knurtz/WordclockX/Mechanical/uhr_komplett.STL

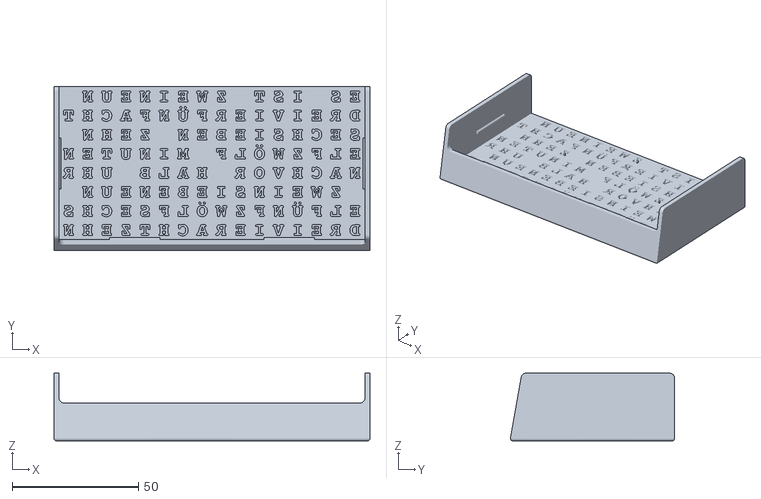
[picture p1: CAD file, 2023-04-30]
Mechanical/uhr_komplett.STL
125.0 x 65.0 x 26.8
