knurtz/WordclockX/Mechanical/uhr_unten_links.STL

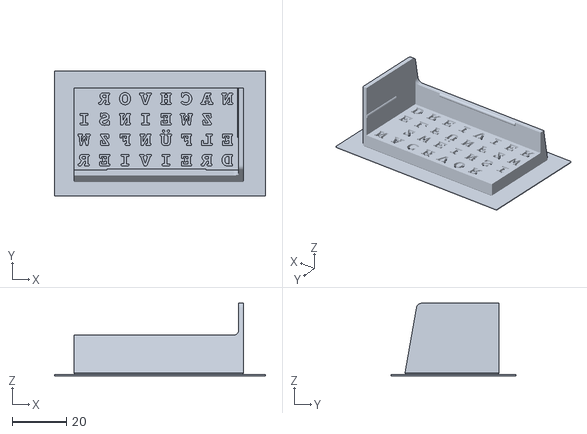
[picture p2: CAD file, 2023-04-30]
Mechanical/uhr_unten_links.STL
77.8 x 46.1 x 26.8
