knurtz/WordclockX/Mechanical/WordclockFrame.stl

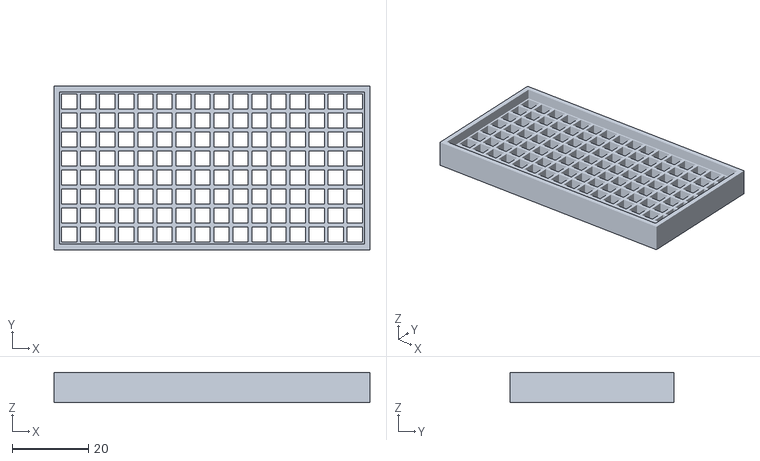
[picture p3: CAD file, 2023-04-30]
Mechanical/WordclockFrame.stl
83.0 x 43.0 x 8.00
