knurtz/WordclockX/Mechanical/uhr_oben_links.STL

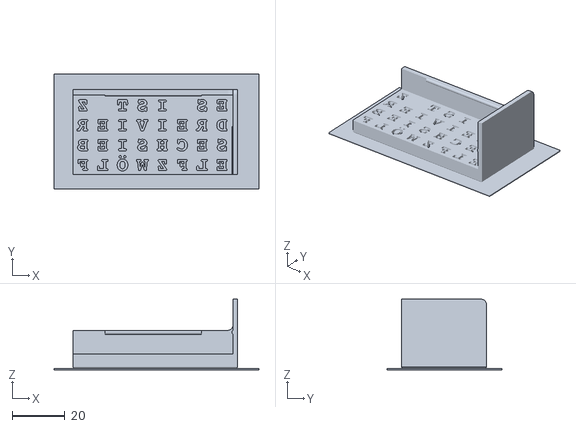
[picture p4: CAD file, 2023-04-30]
Mechanical/uhr_oben_links.STL
77.8 x 43.6 x 26.8
