knurtz/WordclockX/Mechanical/uhr_unten_rechts.STL

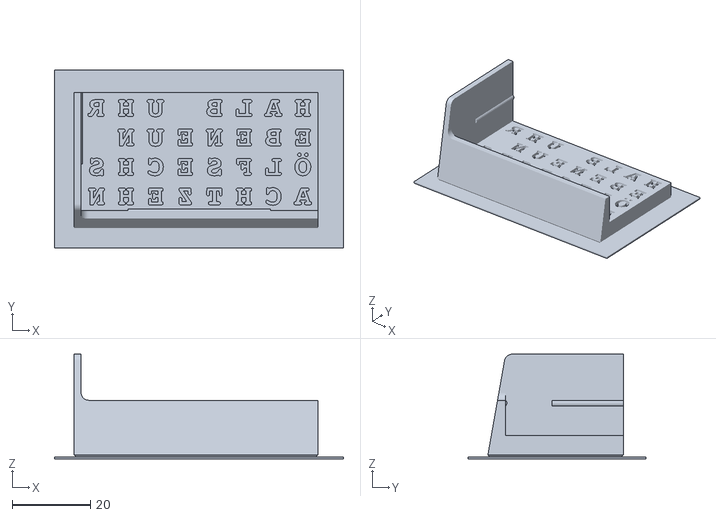
[picture p5: CAD file, 2023-04-30]
Mechanical/uhr_unten_rechts.STL
74.0 x 45.7 x 26.8
