knurtz/WordclockX/Mechanical/uhr_oben_rechts.STL

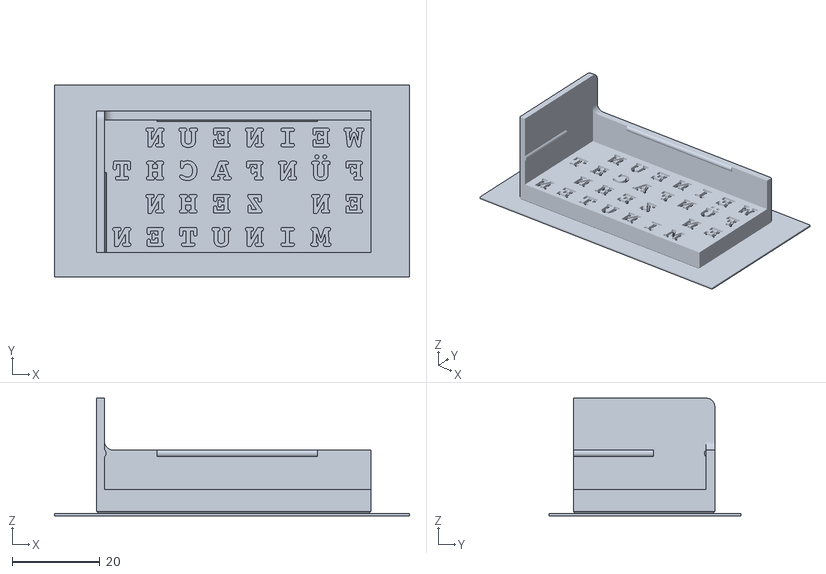
[picture p6: CAD file, 2023-04-30]
Mechanical/uhr_oben_rechts.STL
80.9 x 43.6 x 26.8
