knurtz/WordclockX/(list of files, cad)

Other CAD files:
Letters/letters.dxf
