knurtz/WordclockX/Board/WordclockX.kicad_pcb

## KiCad design Board/WordclockX.kicad_pcb (2023-06-25)

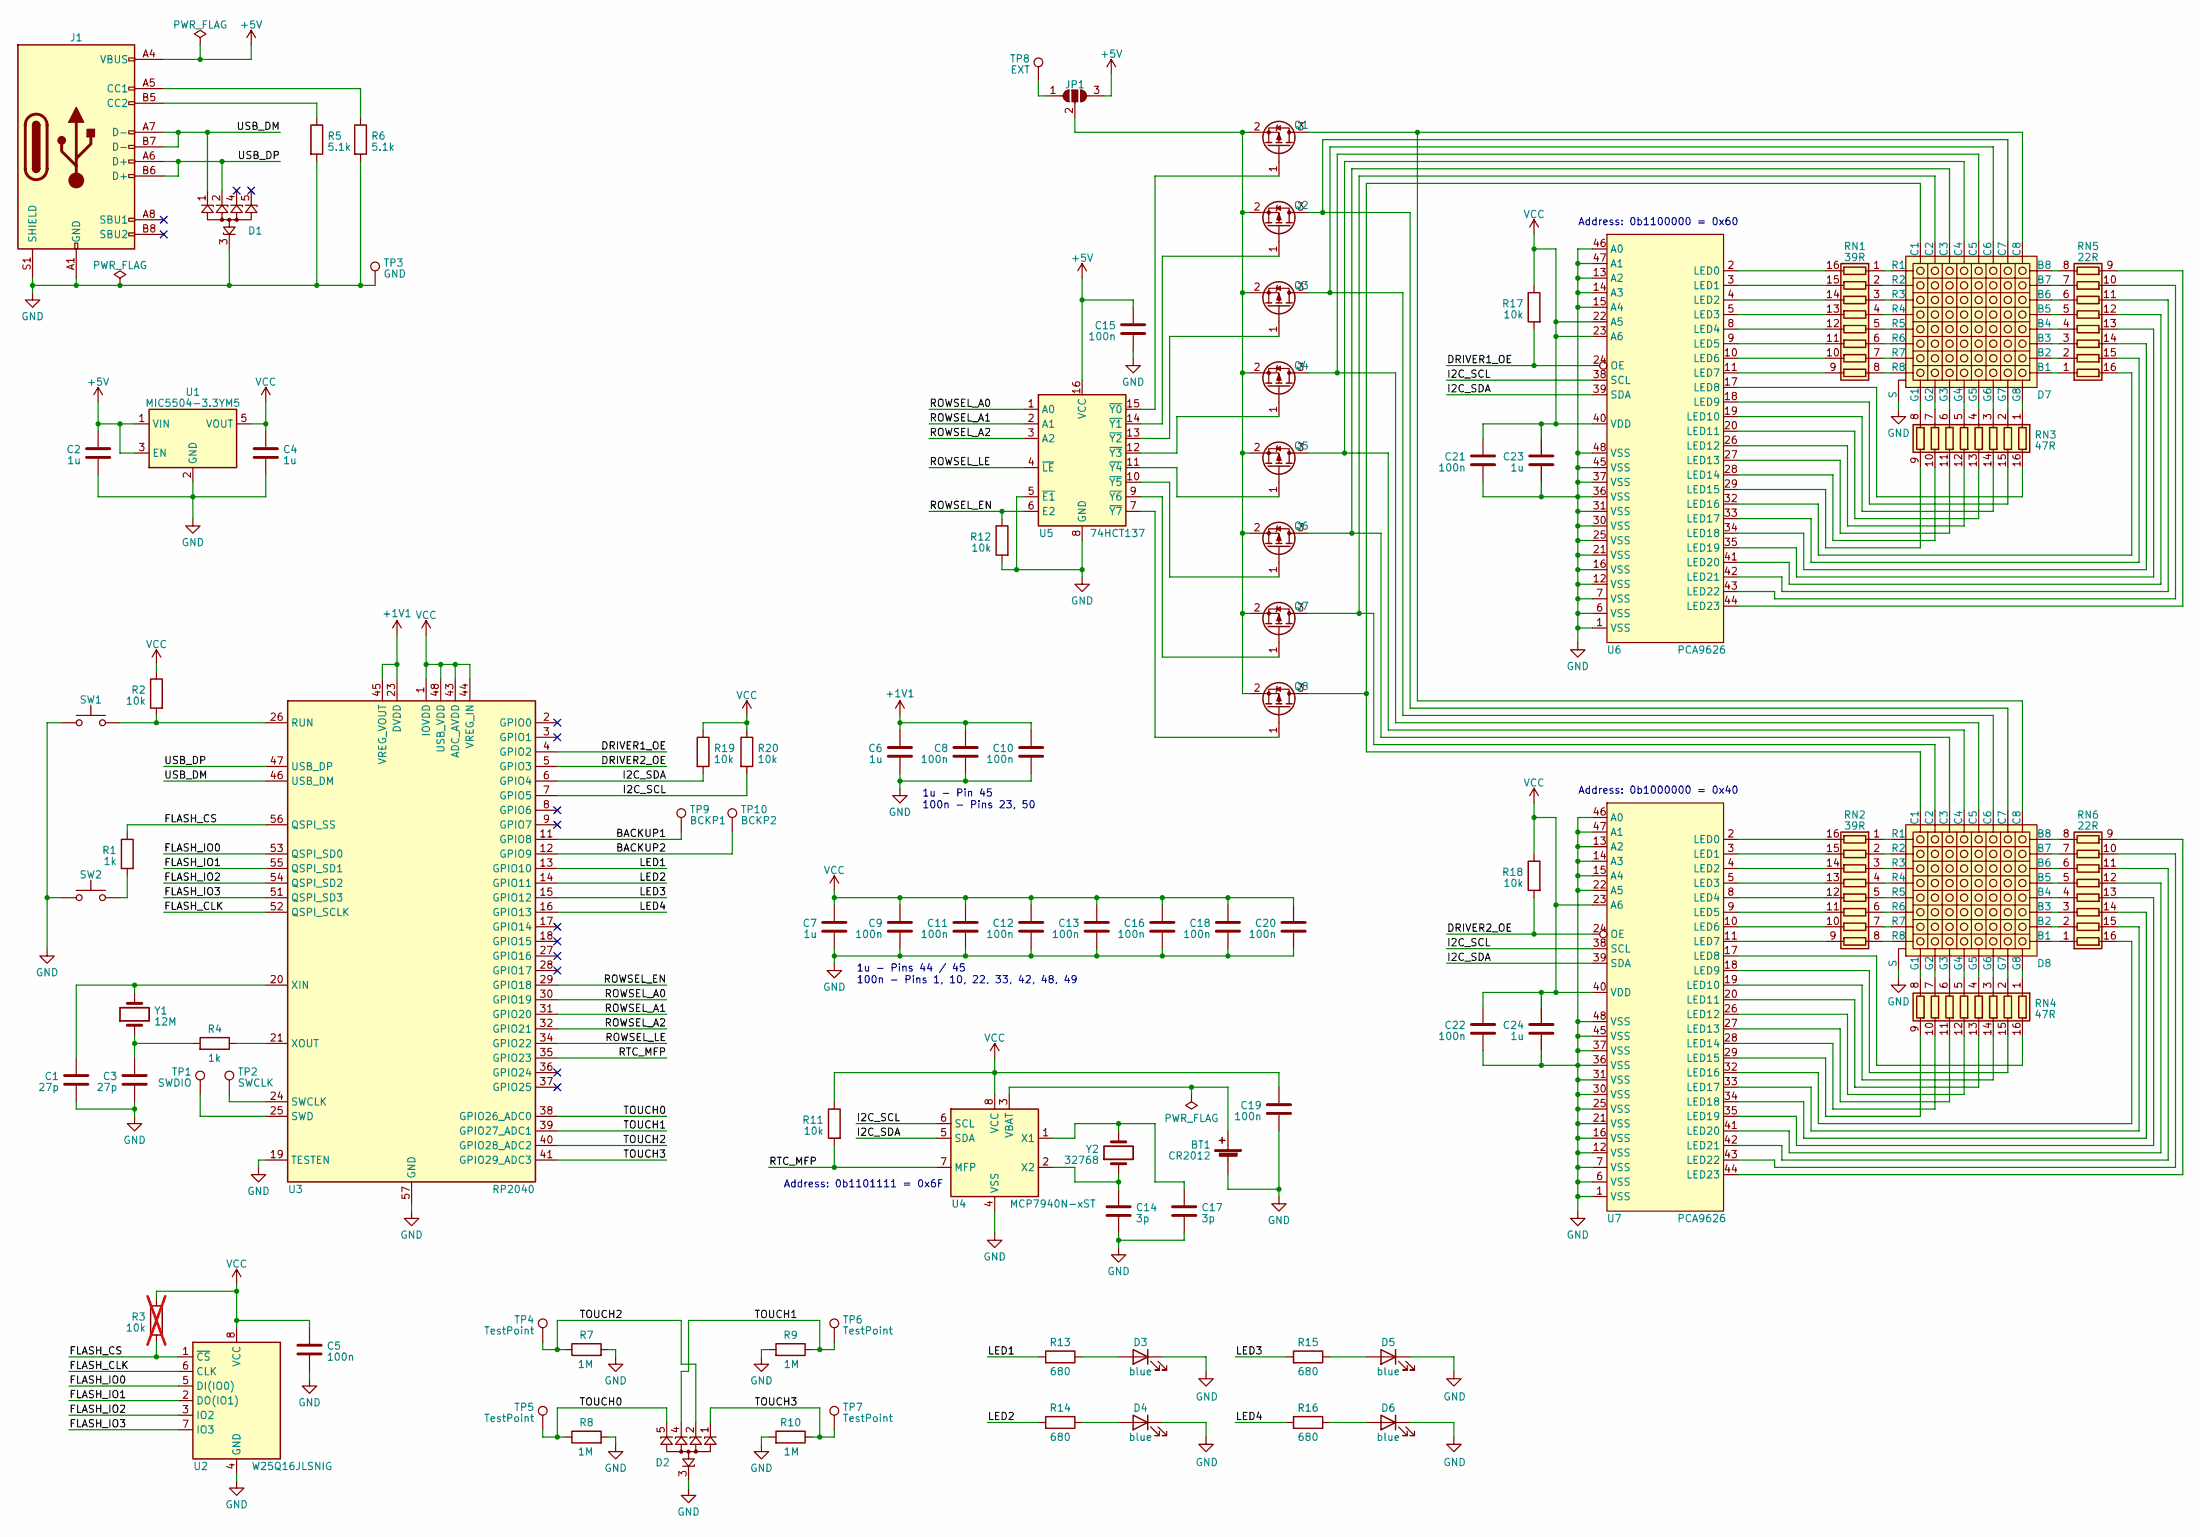
[picture p7: schematic WordclockX.kicad_sch]

Parts:
BT1: CR2012; BatteryHolder_MPD_BC2003_1x2032; Mouser 712-BAT-HLD-002-SMT
C1, C3: 27p; C_0603_1608Metric
C2, C4, C6, C7, C23, C24: 1u; C_0805_2012Metric
C5, C8, C9, C10, C11, C12, C13, C15, C16, C18, C19, C20, C21, C22: 100n; C_0603_1608Metric
C14, C17: 3p; C_0603_1608Metric
D1, D2: Diodes_UDFN-10_1.0x2.5mm_P0.5mm; Mouser 576-SP1064E-04UTG
D3, D4, D5, D6: blue; LED_0603_1608Metric; Mouser 710-150060BS75000
D7, D8: RGB2088-5; 2088RGB-5_no-holes
J1: USB_C_Receptacle_USB2.0; USB_C_Receptacle_GCT_USB4145
JP1: SolderJumper_3_Open; SolderJumper-3_P1.3mm_Open_RoundedPad1.0x1.5mm
Q1, Q2, Q3, Q4, Q5, Q6, Q7, Q8: SOT-23; Mouser 241-PJA3415AAUR100A1
R1, R4: 1k; R_0603_1608Metric
R2, R11, R12, R17, R18, R19, R20: 10k; R_0603_1608Metric
R3: 10k; R_0603_1608Metric; not fitted
R5, R6: 5.1k; R_0603_1608Metric
R7, R8, R9, R10: 1M; R_0603_1608Metric
R13, R14, R15, R16: 680; R_0603_1608Metric
RN1, RN2: 39R; R_Array_Convex_8x0602; Mouser 667-EXB-2HV390JV
RN3, RN4: 47R; R_Array_Convex_8x0602; Mouser 667-EXB-2HV470JV
RN5, RN6: 22R; R_Array_Convex_8x0602; Mouser 667-EXB-2HV220JV
SW1, SW2: SW_Push_Dual; SW_Push_1P1T_NO_CK_KSC6xxJ
TP1: SWDIO; TestPoint_Pad_1.0x1.0mm
TP2: SWCLK; TestPoint_Pad_1.0x1.0mm
TP3: GND; TestPoint_Pad_1.0x1.0mm
TP4, TP5, TP6, TP7: TestPoint; TestPoint_Pad_D4.0mm
TP8: EXT; TestPoint_Pad_1.0x1.0mm
TP9: BCKP1; TestPoint_Pad_1.0x1.0mm
TP10: BCKP2; TestPoint_Pad_1.0x1.0mm
U1: MIC5504-3.3YM5; SOT-23-5; Mouser 998-MIC5504-3.3YM5TR
U2: W25Q16JLSNIG; SOIC-8_3.9x4.9mm_P1.27mm; Mouser 454-W25Q16JLSNIG
U3: RP2040; QFN-56-1EP_7x7mm_P0.4mm_EP3.2x3.2mm
U4: MCP7940N-xST; TSSOP-8_4.4x3mm_P0.65mm; Mouser 579-MCP7940N-I/ST
U5: 74HCT137; SOIC-16_3.9x9.9mm_P1.27mm; Mouser 595-CD74HCT137MT
U6, U7: PCA9626; LQFP-48_7x7mm_P0.5mm
Y1: 12M; Crystal_SMD_5032-2Pin_5.0x3.2mm; Mouser 774-445C25D12M00000
Y2: 32768; Crystal_SMD_3215-2Pin_3.2x1.5mm; Mouser 628-SC32S-7PF20PPM

Connections:
+1V1: C6.1, C8.1, C10.1, U3.23 (DVDD), U3.45 (VREG_VOUT), U3.50 (DVDD)
+5V: C2.1, C15.1, J1.A4 (VBUS), J1.A9 (VBUS), J1.B4 (VBUS), J1.B9 (VBUS), JP1.3 (B), U1.1 (VIN), U1.3 (EN), U5.16 (VCC)
/BACKUP1: TP9.1, U3.11 (GPIO8)
/BACKUP2: TP10.1, U3.12 (GPIO9)
/DRIVER1_OE: R17.2, U3.4 (GPIO2), U6.24 (OE)
/DRIVER2_OE: R18.2, U3.5 (GPIO3), U7.24 (OE)
/FLASH_CLK: U2.6 (CLK), U3.52 (QSPI_SCLK)
/FLASH_CS: R1.1, R3.2, U2.1 (~CS), U3.56 (QSPI_SS)
/FLASH_IO0: U2.5 (DI(IO0)), U3.53 (QSPI_SD0)
/FLASH_IO1: U2.2 (DO(IO1)), U3.55 (QSPI_SD1)
/FLASH_IO2: U2.3 (IO2), U3.54 (QSPI_SD2)
/FLASH_IO3: U2.7 (IO3), U3.51 (QSPI_SD3)
/I2C_SCL: R20.2, U3.7 (GPIO5), U4.6 (SCL), U6.38 (SCL), U7.38 (SCL)
/I2C_SDA: R19.2, U3.6 (GPIO4), U4.5 (SDA), U6.39 (SDA), U7.39 (SDA)
/LED1: R13.2, U3.13 (GPIO10)
/LED2: R14.2, U3.14 (GPIO11)
/LED3: R15.2, U3.15 (GPIO12)
/LED4: R16.2, U3.16 (GPIO13)
/ROWSEL_A0: U3.30 (GPIO19), U5.1 (A0)
/ROWSEL_A1: U3.31 (GPIO20), U5.2 (A1)
/ROWSEL_A2: U3.32 (GPIO21), U5.3 (A2)
/ROWSEL_EN: R12.1, U3.29 (GPIO18), U5.6 (E2)
/ROWSEL_LE: U3.34 (GPIO22), U5.4 (~LE)
/RTC_MFP: R11.2, U3.35 (GPIO23), U4.7 (MFP)
/TOUCH0: D2.5 (Ch.4), D2.6 (Ch.4), R8.1, TP5.1, U3.38 (GPIO26_ADC0)
/TOUCH1: D2.4 (Ch.3), D2.7 (Ch.3), R9.1, TP6.1, U3.39 (GPIO27_ADC1)
/TOUCH2: D2.2 (Ch.2), D2.9 (Ch.2), R7.1, TP4.1, U3.40 (GPIO28_ADC2)
/TOUCH3: D2.1 (Ch.1), D2.10 (Ch.1), R10.1, TP7.1, U3.41 (GPIO29_ADC3)
/USB_DM: D1.1 (Ch.1), D1.10 (Ch.1), J1.A7 (D-), J1.B7 (D-), U3.46 (USB_DM)
/USB_DP: D1.2 (Ch.2), D1.9 (Ch.2), J1.A6 (D+), J1.B6 (D+), U3.47 (USB_DP)
GND: BT1.2 (-), C1.2, C2.2, C3.2, C4.2, C5.2, C6.2, C7.2, C8.2, C9.2, C10.2, C11.2, C12.2, C13.2, C14.2, C15.2, C16.2, C17.2, C18.2, C19.2, C20.2, C21.2, C22.2, C23.2, C24.2, D1.3 (GND), D1.8 (GND), D2.3 (GND), D2.8 (GND), D3.1 (K), D4.1 (K), D5.1 (K), D6.1 (K), D7.S, D8.S, J1.A1 (GND), J1.A12 (GND), J1.B1 (GND), J1.B12 (GND), J1.S1 (SHIELD), R5.2, R6.2, R7.2, R8.2, R9.2, R10.2, R12.2, SW1.1, SW2.1, TP3.1, U1.2 (GND), U2.4 (GND), U3.19 (TESTEN), U3.57 (GND), U4.4 (VSS), U5.5 (~E1), U5.8 (GND), U6.1 (VSS), U6.6 (VSS), U6.7 (VSS), U6.12 (VSS), U6.13 (A2), U6.14 (A3), U6.15 (A4), U6.16 (VSS), U6.21 (VSS), U6.25 (VSS), U6.30 (VSS), U6.31 (VSS), U6.36 (VSS), U6.37 (VSS), U6.45 (VSS), U6.46 (A0), U6.47 (A1), U6.48 (VSS), U7.1 (VSS), U7.6 (VSS), U7.7 (VSS), U7.12 (VSS), U7.13 (A2), U7.14 (A3), U7.15 (A4), U7.16 (VSS), U7.21 (VSS), U7.22 (A5), U7.25 (VSS), U7.30 (VSS), U7.31 (VSS), U7.36 (VSS), U7.37 (VSS), U7.45 (VSS), U7.46 (A0), U7.47 (A1), U7.48 (VSS)
unnamed: BT1.1 (+), U4.3 (VBAT)
unnamed: C3.1, R4.2, Y1.1
unnamed: D3.2 (A), R13.1
unnamed: D4.2 (A), R14.1
unnamed: D5.2 (A), R15.1
unnamed: D6.2 (A), R16.1
unnamed: D7.1 (B1), RN5.1 (R1.1)
unnamed: D7.2 (B2), RN5.2 (R2.1)
unnamed: D7.3 (B3), RN5.3 (R3.1)
unnamed: D7.4 (B4), RN5.4 (R4.1)
unnamed: D7.5 (B5), RN5.5 (R5.1)
unnamed: D7.6 (B6), RN5.6 (R6.1)
unnamed: D7.7 (B7), RN5.7 (R7.1)
unnamed: D7.8 (B8), RN5.8 (R8.1)
unnamed: D7.17 (C1), D8.17 (C1), Q8.3 (D)
unnamed: D7.18 (C2), D8.18 (C2), Q7.3 (D)
unnamed: D7.19 (C3), D8.19 (C3), Q6.3 (D)
unnamed: D7.20 (C4), D8.20 (C4), Q5.3 (D)
unnamed: D7.29 (C5), D8.29 (C5), Q4.3 (D)
unnamed: D7.30 (C6), D8.30 (C6), Q3.3 (D)
unnamed: D7.31 (C7), D8.31 (C7), Q2.3 (D)
unnamed: D7.32 (C8), D8.32 (C8), Q1.3 (D)
unnamed: D7.28 (G1), RN3.8 (R8.1)
unnamed: D7.27 (G2), RN3.7 (R7.1)
unnamed: D7.26 (G3), RN3.6 (R6.1)
unnamed: D7.25 (G4), RN3.5 (R5.1)
unnamed: D7.24 (G5), RN3.4 (R4.1)
unnamed: D7.23 (G6), RN3.3 (R3.1)
unnamed: D7.22 (G7), RN3.2 (R2.1)
unnamed: D7.21 (G8), RN3.1 (R1.1)
unnamed: D7.9 (R1), RN1.1 (R1.1)
unnamed: D7.10 (R2), RN1.2 (R2.1)
unnamed: D7.11 (R3), RN1.3 (R3.1)
unnamed: D7.12 (R4), RN1.4 (R4.1)
unnamed: D7.13 (R5), RN1.5 (R5.1)
unnamed: D7.14 (R6), RN1.6 (R6.1)
unnamed: D7.15 (R7), RN1.7 (R7.1)
unnamed: D7.16 (R8), RN1.8 (R8.1)
unnamed: D8.1 (B1), RN6.1 (R1.1)
unnamed: D8.2 (B2), RN6.2 (R2.1)
unnamed: D8.3 (B3), RN6.3 (R3.1)
unnamed: D8.4 (B4), RN6.4 (R4.1)
unnamed: D8.5 (B5), RN6.5 (R5.1)
unnamed: D8.6 (B6), RN6.6 (R6.1)
unnamed: D8.7 (B7), RN6.7 (R7.1)
unnamed: D8.8 (B8), RN6.8 (R8.1)
unnamed: D8.28 (G1), RN4.8 (R8.1)
unnamed: D8.27 (G2), RN4.7 (R7.1)
unnamed: D8.26 (G3), RN4.6 (R6.1)
unnamed: D8.25 (G4), RN4.5 (R5.1)
unnamed: D8.24 (G5), RN4.4 (R4.1)
unnamed: D8.23 (G6), RN4.3 (R3.1)
unnamed: D8.22 (G7), RN4.2 (R2.1)
unnamed: D8.21 (G8), RN4.1 (R1.1)
unnamed: D8.9 (R1), RN2.1 (R1.1)
unnamed: D8.10 (R2), RN2.2 (R2.1)
unnamed: D8.11 (R3), RN2.3 (R3.1)
unnamed: D8.12 (R4), RN2.4 (R4.1)
unnamed: D8.13 (R5), RN2.5 (R5.1)
unnamed: D8.14 (R6), RN2.6 (R6.1)
unnamed: D8.15 (R7), RN2.7 (R7.1)
unnamed: D8.16 (R8), RN2.8 (R8.1)
unnamed: J1.A5 (CC1), R6.1
unnamed: J1.B5 (CC2), R5.1
unnamed: JP1.1 (A), TP8.1
unnamed: JP1.2 (C), Q1.2 (S), Q2.2 (S), Q3.2 (S), Q4.2 (S), Q5.2 (S), Q6.2 (S), Q7.2 (S), Q8.2 (S)
unnamed: Q1.1 (G), U5.15 (~Y0)
unnamed: Q2.1 (G), U5.14 (~Y1)
unnamed: Q3.1 (G), U5.13 (~Y2)
unnamed: Q4.1 (G), U5.12 (~Y3)
unnamed: Q5.1 (G), U5.11 (~Y4)
unnamed: Q6.1 (G), U5.10 (~Y5)
unnamed: Q7.1 (G), U5.9 (~Y6)
unnamed: Q8.1 (G), U5.7 (~Y7)
unnamed: R1.2, SW2.2
unnamed: RN1.16 (R1.2), U6.2 (LED0)
unnamed: RN1.15 (R2.2), U6.3 (LED1)
unnamed: RN1.14 (R3.2), U6.4 (LED2)
unnamed: RN1.13 (R4.2), U6.5 (LED3)
unnamed: RN1.12 (R5.2), U6.8 (LED4)
unnamed: RN1.11 (R6.2), U6.9 (LED5)
unnamed: RN1.10 (R7.2), U6.10 (LED6)
unnamed: RN1.9 (R8.2), U6.11 (LED7)
unnamed: RN2.16 (R1.2), U7.2 (LED0)
unnamed: RN2.15 (R2.2), U7.3 (LED1)
unnamed: RN2.14 (R3.2), U7.4 (LED2)
unnamed: RN2.13 (R4.2), U7.5 (LED3)
unnamed: RN2.12 (R5.2), U7.8 (LED4)
unnamed: RN2.11 (R6.2), U7.9 (LED5)
unnamed: RN2.10 (R7.2), U7.10 (LED6)
unnamed: RN2.9 (R8.2), U7.11 (LED7)
unnamed: RN3.16 (R1.2), U6.17 (LED8)
unnamed: RN3.15 (R2.2), U6.18 (LED9)
unnamed: RN3.14 (R3.2), U6.19 (LED10)
unnamed: RN3.13 (R4.2), U6.20 (LED11)
unnamed: RN3.12 (R5.2), U6.26 (LED12)
unnamed: RN3.11 (R6.2), U6.27 (LED13)
unnamed: RN3.10 (R7.2), U6.28 (LED14)
unnamed: RN3.9 (R8.2), U6.29 (LED15)
unnamed: RN4.16 (R1.2), U7.17 (LED8)
unnamed: RN4.15 (R2.2), U7.18 (LED9)
unnamed: RN4.14 (R3.2), U7.19 (LED10)
unnamed: RN4.13 (R4.2), U7.20 (LED11)
unnamed: RN4.12 (R5.2), U7.26 (LED12)
unnamed: RN4.11 (R6.2), U7.27 (LED13)
unnamed: RN4.10 (R7.2), U7.28 (LED14)
unnamed: RN4.9 (R8.2), U7.29 (LED15)
unnamed: RN5.16 (R1.2), U6.32 (LED16)
unnamed: RN5.15 (R2.2), U6.33 (LED17)
unnamed: RN5.14 (R3.2), U6.34 (LED18)
unnamed: RN5.13 (R4.2), U6.35 (LED19)
unnamed: RN5.12 (R5.2), U6.41 (LED20)
unnamed: RN5.11 (R6.2), U6.42 (LED21)
unnamed: RN5.10 (R7.2), U6.43 (LED22)
unnamed: RN5.9 (R8.2), U6.44 (LED23)
unnamed: RN6.16 (R1.2), U7.32 (LED16)
unnamed: RN6.15 (R2.2), U7.33 (LED17)
unnamed: RN6.14 (R3.2), U7.34 (LED18)
unnamed: RN6.13 (R4.2), U7.35 (LED19)
unnamed: RN6.12 (R5.2), U7.41 (LED20)
unnamed: RN6.11 (R6.2), U7.42 (LED21)
unnamed: RN6.10 (R7.2), U7.43 (LED22)
unnamed: RN6.9 (R8.2), U7.44 (LED23)
unnamed: R2.2, SW1.2, U3.26 (RUN)
unnamed: TP2.1, U3.24 (SWCLK)
unnamed: TP1.1, U3.25 (SWD)
unnamed: C1.1, U3.20 (XIN), Y1.2
unnamed: R4.1, U3.21 (XOUT)
unnamed: C17.1, U4.1 (X1), Y2.2
unnamed: C14.1, U4.2 (X2), Y2.1
VCC: C4.1, C5.1, C7.1, C9.1, C11.1, C12.1, C13.1, C16.1, C18.1, C19.1, C20.1, C21.1, C22.1, C23.1, C24.1, R2.1, R3.1, R11.1, R17.1, R18.1, R19.1, R20.1, U1.5 (VOUT), U2.8 (VCC), U3.1 (IOVDD), U3.10 (IOVDD), U3.22 (IOVDD), U3.33 (IOVDD), U3.42 (IOVDD), U3.43 (ADC_AVDD), U3.44 (VREG_IN), U3.48 (USB_VDD), U3.49 (IOVDD), U4.8 (VCC), U6.22 (A5), U6.23 (A6), U6.40 (VDD), U7.23 (A6), U7.40 (VDD)

Notes on the sheet:
Address: 0b1000000 = 0x40
1u - Pin 45 100n - Pins 23, 50
1u - Pins 44 / 45 100n - Pins 1, 10, 22, 33, 42, 48, 49
Address: 0b1101111 = 0x6F
Address: 0b1100000 = 0x60

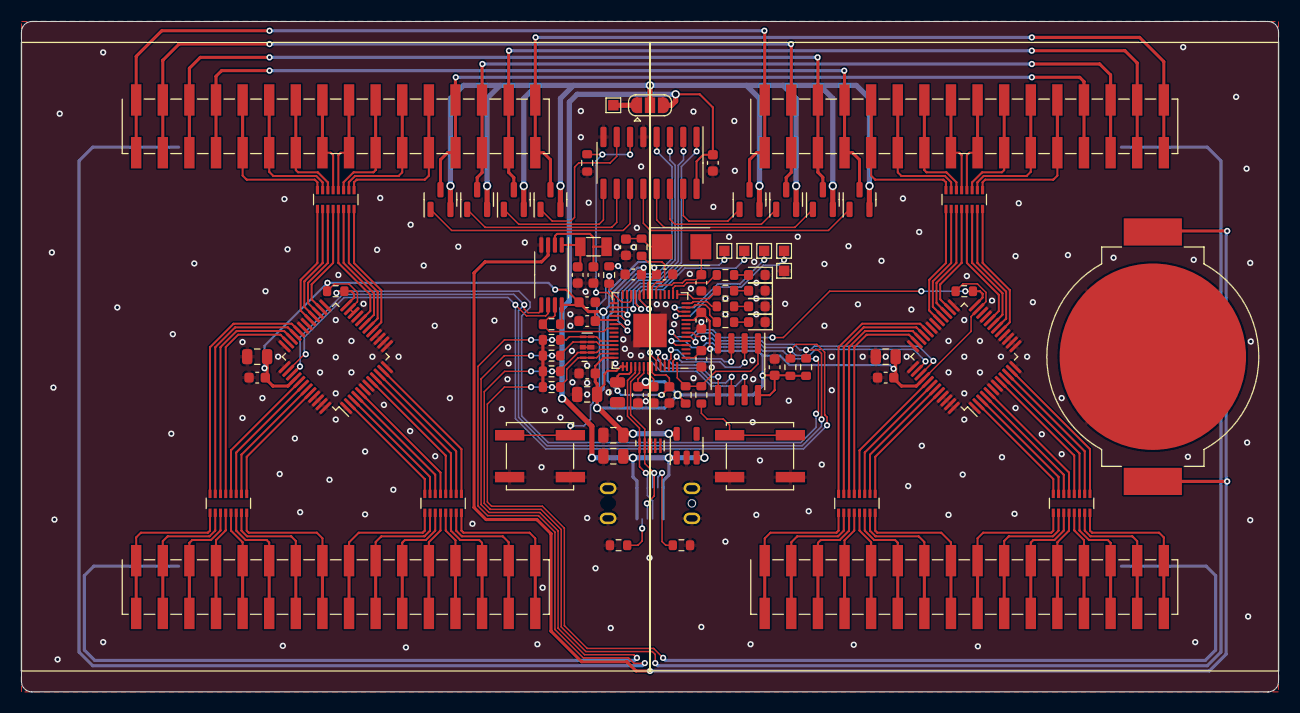
[picture p8: board WordclockX.kicad_pcb from above]

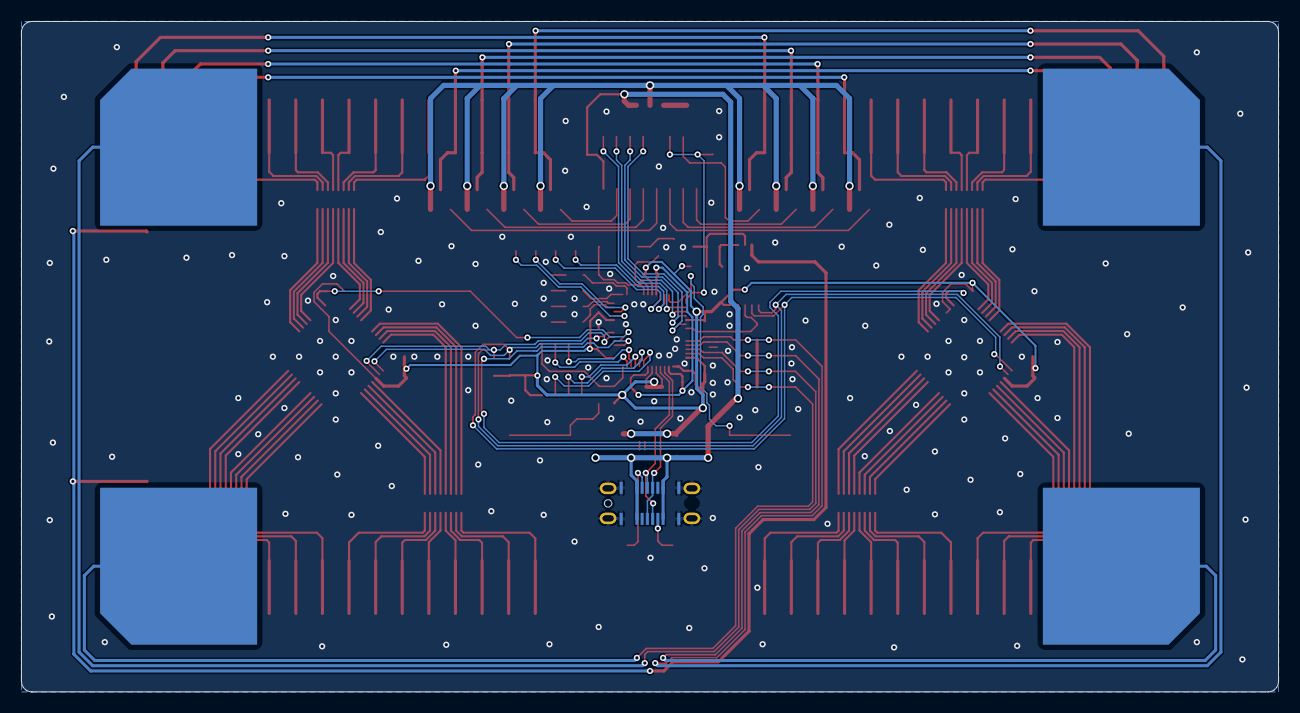
[picture p9: board WordclockX.kicad_pcb from below]

Board: 2 copper layers, 120.0 x 64.0 mm, 90 parts (5 on the bottom side), 162 nets.
