knurtz/WordclockX/Code/hardware/hardware.h

#ifndef HARDWARE_H
#define HARDWARE_H

#include "pico/stdlib.h"

#define kHz * 1000
#define MHz * 1000 * 1000

// Generic IOs
#define LED1                    10
#define LED2                    11
#define LED3                    12
#define LED4                    13

// I2C
#define I2C_SDA                 4
#define I2C_SCL                 5

// Row selection
#define ROWSEL_A0               19
#define ROWSEL_A1               20
#define ROWSEL_A2               21

#define ROWSEL_LATCH            22
#define ROWSEL_EN               18

// Column selection
#define DRIVER1_NOE              2
#define DRIVER2_NOE              3

// Initializes all GPIOs
bool Hardware_Init(void);

#endif /* HARDWARE_H */
