knurtz/WordclockX/(commit log)

2023-04-30 16x8 letter array for word clock
    [WordclockFrame.stl, letters.dxf, uhr_komplett.STL, uhr_oben_links.STL, uhr_oben_rechts.STL, uhr_unten_links.STL, uhr_unten_rechts.STL]
2023-04-30 First version of schematic almost done.
    [WordclockX.kicad_pcb, WordclockX.kicad_sch]
2023-05-01 Some additions to the schematic
    [WordclockX.kicad_sch]
2023-05-02 Sized our board and placed LEDs to final location
    [WordclockX.kicad_pcb, WordclockX.kicad_sch]
2023-05-03 Added capacitors and pin assignments, also new footprint for LED array without holes
    [WordclockX.kicad_sch]
2023-05-04 Placed some resistors
    [WordclockX.kicad_pcb, WordclockX.kicad_sch]
2023-05-05 Started adding DC/DC converter for LED supply
    [WordclockX.kicad_sch]
2023-05-08 Finished adding voltage regulators
    [WordclockX.kicad_sch]
2023-05-08 Removed regulators again, probably overkill
    [WordclockX.kicad_sch]
2023-05-08 Replaced individual resistors with resistor arrays
    [WordclockX.kicad_sch]
2023-05-08 Added product links and footprints to resistor arrays
    [WordclockX.kicad_sch]
2023-06-05 Assigned missing footprints
    [WordclockX.kicad_pcb, WordclockX.kicad_sch]
2023-06-09 Placement of components done
    [WordclockX.kicad_pcb, WordclockX.kicad_sch]
2023-06-09 Most of the routing done, I2C pullups missing!
    [WordclockX.kicad_pcb, WordclockX.kicad_sch]
2023-06-11 Routing almost done. Only touch buttons and battery supply missing.
    [WordclockX.kicad_pcb, WordclockX.kicad_sch]
2023-06-21 All routing done
    [WordclockX.kicad_pcb, WordclockX.kicad_sch]
2023-06-25 Finished board for production
    [WordclockX.kicad_pcb, WordclockX.kicad_sch]
2023-06-29 Added base code for RP2040 project
    [WordclockX.kicad_pcb]
2023-07-08 Added interactive HTML BOM
2023-07-08 Base code running LEDs
2023-07-14 Added code for status LED and I2C scan
2023-07-14 Rescued board file from old commit
    [WordclockX.kicad_pcb]
2023-07-18 LED matrix lit up
2023-07-19 Added pixel framebuffer
2023-07-25 Matrix works without burning up, added HSV2RGB code from someone else
    [fast_hsv2rgb.c, fast_hsv2rgb.h, led_matrix.c, main.c, shell_commands.c]
